sidtupper/WX-system/(list of files, drawings)

Other design files:
hardware/gateway/gateway.dsn
hardware/midpoint/midpoint.dsn
hardware/station/station.dsn
