sidtupper/WX-system/docs/Station_Pi_Hardware_Software_Maintenance_Manual.docx

# Station Pi Hardware & Software Maintenance Manual

Raspberry Pi 4B remote weather-station controller
Configuration captured 27 August 2026

Purpose. A practical maintenance record of the Station Pi hardware interfaces, software services, boot configuration, networking, data flow, backup strategy, and diagnostic procedures. It is intended to make future maintenance possible without relying on memory.

Important: this manual distinguishes verified configuration from items that still need review. Do not change working UART or power-monitor settings solely to make comments or old documentation look consistent.

# 1. System overview

The Station Pi is the shore-side Raspberry Pi 4B controller for the weather station. It acquires local weather and enclosure measurements, displays observations on the enclosure TFT, logs observations locally, and normally forwards a formatted observation packet to the station ESP32/LoRa subsystem. Protective functions such as enclosure heating, door-controlled display backlight, safe shutdown, and Wi-Fi fallback run as independent services.

Function | Implementation
Main controller | Raspberry Pi 4B, 64-bit Linux
System disk | T-FORCE 256 GB USB SSD; root on /dev/sda2, boot on /dev/sda1
Emergency boot disk | 32 GB microSD, tested bootable independently of SSD
Main program | /home/pi/wx/scripts/station.py
Observation interval | 30 s (current station.py default)
Local observations | /home/pi/wx/data/weather.csv and /home/pi/wx/data/latest.txt
Maintenance access | SSH/SFTP; fallback AP WX-STATION at 10.42.0.1

# 2. Hardware interface map

BCM GPIO | Physical role / interface | Direction / verified state
4 | UART3 TX to station ESP32 | TXD3; verified by pinctrl
5 | UART3 RX from station ESP32 | RXD3; verified by pinctrl
8 | TFT SPI chip select | Output
10 | TFT SPI MOSI | SPI0_MOSI
11 | TFT SPI clock | SPI0_SCLK
12 | RS-485 UART5 TX | TXD5; verified by pinctrl
13 | RS-485 UART5 RX | RXD5; verified by pinctrl
16 | Enclosure heater MOSFET gate | Output; active high
17 | TFT backlight | Output; high = backlight on
20 | Normally-closed door switch | Input pull-up; LOW when door open
21 | Safe shutdown toggle | Input pull-up; grounded when closed
24 | TFT reset | Output
25 | TFT data/command | Output
27 | 1-Wire DS18B20 bus | Input / w1-gpio

# 3. Sensors and buses

Device | Interface | Address / port | Notes
Wind Mini-C5A | RS-485 Modbus RTU | Slave 1, /dev/ttyAMA5, 9600 8N1 | Speed, direction, air temperature, RH, pressure
Rain SN-3001-GYL-N01 | RS-485 Modbus RTU | Slave 2, /dev/ttyAMA5, 9600 8N1 | Rainfall
BME280 | I2C bus 1 | 0x76 | Enclosure T/RH for heater; also detected by POST
INA226 | I2C bus 1 | 0x40 | Station supply voltage/current
DS18B20 x2 | 1-Wire | GPIO27 | Sea and cabinet temperature; POST expects at least two
GPS receiver | Serial | /dev/serial0, 9600 | POST accepts usable RMC/GGA NMEA
TFT | SPI0 | GPIO8/10/11 plus GPIO24/25 | stationio.ili9488 driver
Station ESP32 | UART3 | /dev/ttyAMA3, GPIO4/5, 9600 | Observation packet output; local logging should continue if unavailable

# 4. Power and enclosure protection

## 4.1 Enclosure heater

A nominal 10 W / 12 V heater is bonded to the aluminium mounting plate and switched on the low side by an IRLZ44N MOSFET controlled from GPIO16. A measured 11.8 V across the heater while on confirmed approximately rated operation.

Condition | Action
RH >= 75% | Turn heater ON
Temperature - dew point <= 2 C | Turn heater ON
RH <= 65% AND dew-point margin >= 5 C | Turn heater OFF
Reading interval | 30 s

The heater controller is intentionally independent of station.py. Thus condensation protection remains active if the main acquisition program is stopped, upgraded, or crashes.

## 4.2 Safe shutdown switch

Physical header pin 40 (BCM GPIO21) is connected to ground by the shutdown toggle. The service does not arm until it has observed the switch open/high, preventing a switch left closed from immediately shutting the Pi down after reboot. After arming, holding GPIO21 low for one second invokes systemctl poweroff.

## 4.3 Door-controlled TFT backlight

The normally-closed door switch connects GPIO20 to ground when the enclosure door is open. GPIO20 therefore reads LOW when open and HIGH via its internal pull-up when closed. The door-backlight service drives GPIO17 HIGH when the door is open and LOW when closed.

# 5. Boot configuration

Current SSD boot identifiers:

/boot/firmware PARTUUID=73a882b0-01

/ PARTUUID=73a882b0-02

Current cmdline.txt:

console=tty1 root=PARTUUID=73a882b0-02 rootfstype=ext4 fsck.repair=yes rootwait cfg80211.ieee80211_regdom=CA

Relevant config.txt settings:

dtparam=i2c_arm=on

dtparam=spi=on

arm_64bit=1

enable_uart=1

dtoverlay=w1-gpio,gpiopin=27

dtoverlay=uart5,txd4_pin=12,rxd4_pin=13

dtoverlay=uart3,txd3_pin=4

Verified runtime pinctrl mapping is authoritative for maintenance: GPIO12=TXD5, GPIO13=RXD5, GPIO4=TXD3 and GPIO5=RXD3. The uart5 overlay line contains parameter names 'txd4_pin'/'rxd4_pin', and the ESP32 comment in config.txt is stale. Because the runtime mapping has been verified and is working, review these lines deliberately rather than changing them casually.

# 6. Software architecture and systemd services

Service | Program | Behaviour
station.service | /home/pi/wx/scripts/station.py | User pi; working dir /home/pi/wx; 15 s startup delay; Restart=always; RestartSec=10; Nice=5
heater.service | /home/pi/wx/scripts/heater_bme280.py | Independent condensation controller; Restart=always
gpio-shutdown.service | /usr/local/sbin/gpio-shutdown.py | Safe GPIO21 shutdown; Restart=on-failure
door-backlight.service | /usr/local/sbin/door-backlight.py | Door switch GPIO20 -> backlight GPIO17; Restart=on-failure
wx-wifi-fallback.service | /usr/local/sbin/wx-wifi-fallback.sh | One-shot after NetworkManager; RemainAfterExit=yes; 90 s timeout

Useful service commands:

systemctl status station.service heater.service gpio-shutdown.service door-backlight.service wx-wifi-fallback.service

journalctl -u station.service -n 50 --no-pager

journalctl -u heater.service -n 50 --no-pager

journalctl -b

# 7. Main station.py data flow

station.py opens the RS-485 weather bus on /dev/ttyAMA5 and the station ESP32 link on /dev/ttyAMA3. Each successful cycle reads the weather instruments and local sensors, builds an observation record, updates the TFT, writes the observation locally, and attempts transmission to the ESP32.

Observation payload fields, in order:

@epoch,wind_speed,wind_dir,wind_gust,temperature,humidity,barometric_pressure,rain_hour,sea_temp,cabinet_temp,station_battery*CRC

The locally logging version creates /home/pi/wx/data at startup. weather.csv is the accumulating history; latest.txt is replaced with the newest successful observation. Local saving occurs before ESP32 transmission so an unavailable midpoint/LoRa path does not by itself prevent on-site data collection.

# 8. Network design

Saved NetworkManager Wi-Fi profiles are TELUS4628 and stonehouse. The fallback service first stops hostapd/dnsmasq, returns wlan0 to NetworkManager, enables Wi-Fi, and waits up to 60 seconds for a saved client connection with an IPv4 address. If none becomes available it disconnects wlan0 from NetworkManager, marks it unmanaged, assigns 10.42.0.1/24, then starts hostapd and dnsmasq. The expected access-point SSID is WX-STATION.

Situation | Expected access
Home Ethernet (captured state) | 192.168.10.109/24 on eth0
Saved Wi-Fi available | NetworkManager client connection
No saved Wi-Fi available | WX-STATION AP, Pi = 10.42.0.1/24
File maintenance | SFTP over SSH, normally port 22

A captured home-state snapshot showed Ethernet connected at 192.168.10.109 while wlan0 was unmanaged with 10.42.0.1/24, consistent with the fallback AP having been established.

# 9. Power-on self test (run_post.py)

The POST is a manual diagnostic program. It tests wind, rain, BME280, INA226, at least two DS18B20 sensors, GPS/NMEA, filesystem writability/free space, system clock, heater/shutdown/door services, Wi-Fi fallback result, current network/AP state, and TFT initialization. It displays POST PASS only if every recorded test passes; otherwise POST FAIL.

POST default | Value
RS-485 | /dev/ttyAMA5, 9600
Wind slave | 1
Rain slave | 2
BME280 | 0x76
INA226 | 0x40
Expected DS18B20 | 2
GPS | /dev/serial0, 9600
Hotspot | WX-STATION / 10.42.0.1
Minimum free disk | 5 GB

Known discrepancy requiring review: run_post.py currently defaults INA226 shunt resistance to 0.102 ohm, while the current station.py uses 0.0275 ohm with a comment that it was calibrated with a DMM. Do not use POST current readings as a calibration reference until the physical shunt value is confirmed and both programs are made consistent.

# 10. Storage and backup

The primary system is on a 256 GB T-FORCE USB SSD. At the captured state the root filesystem used about 4.4 GB. A 32 GB microSD was built as a file-level clone using rsync, given independent partition identifiers, and successfully test-booted with the SSD disconnected.

Emergency SD partition | Identifier
bootfs | PARTUUID=cabd7190-01
station-backup root | PARTUUID=cabd7190-02

The successful test showed /dev/mmcblk0p1 mounted at /boot/firmware and /dev/mmcblk0p2 mounted at /. Label the card clearly and keep it as an emergency boot disk. A backup is much more valuable after an actual independent boot test, which this card has passed.

## 10.1 Refreshing the emergency SD clone

When refreshing the card, do not raw-dd the 238 GB SSD to the 32 GB card. Recreate suitable FAT/ext4 partitions, rsync the live filesystem with virtual filesystems excluded, then change the clone's cmdline.txt and /etc/fstab to the clone's own PARTUUID values. Always verify device names before formatting.

# 11. Maintenance quick checks

# Root/boot device

findmnt /

findmnt /boot/firmware

lsblk -o NAME,SIZE,FSTYPE,LABEL,MOUNTPOINTS,MODEL

# I2C devices

i2cdetect -y 1

# Expected: 0x40 INA226, 0x76 BME280

# UART devices

ls -l /dev/ttyAMA*

# Expected: ttyAMA3 and ttyAMA5

# GPIO function

for p in 4 5 8 10 11 12 13 16 17 20 21 24 25 27; do pinctrl get $p; done

# Main services

systemctl is-active station.service heater.service gpio-shutdown.service door-backlight.service

systemctl status wx-wifi-fallback.service --no-pager

# Recent station log

journalctl -u station.service -n 100 --no-pager

# Local observations

ls -lh /home/pi/wx/data

tail /home/pi/wx/data/weather.csv

cat /home/pi/wx/data/latest.txt

# 12. Troubleshooting guide

Symptom | Checks
No observations logged | Check station.service journal; confirm /dev/ttyAMA5; verify wind/rain RS-485 responses. A failed sensor cycle can prevent a complete observation.
Wind/rain missing | Check GPIO12/13 pinctrl = TXD5/RXD5, /dev/ttyAMA5 exists, 9600 8N1, slave IDs 1 and 2.
No BME280/heater | i2cdetect -y 1 should show 0x76; check heater.service journal and GPIO16.
Bad battery current | Resolve INA226 shunt-value discrepancy before interpreting current.
TFT dark | Open door; GPIO20 should go LOW and GPIO17 HIGH. Check door-backlight.service.
Pi will not shut down from switch | Ensure switch was first opened after boot so service arms; then GPIO21 LOW for >=1 s.
Cannot reach station at site | Look for WX-STATION; connect and SSH/SFTP to 10.42.0.1. Check hostapd/dnsmasq and wx-wifi-fallback logs.
SSD boot failure | Power off, disconnect SSD, insert tested emergency microSD, boot and verify root is /dev/mmcblk0p2.

# 13. Known issues / items to verify

- INA226 shunt resistance: station.py = 0.0275 ohm; run_post.py = 0.102 ohm. Confirm physical/calibrated value and standardize.
- config.txt uart5 line uses txd4_pin/rxd4_pin parameter names although runtime GPIO12/13 are verified as TXD5/RXD5.
- config.txt comment for the ESP32 link says GPIO19/GPIO26, but verified Station Pi UART3 pins are GPIO4/GPIO5.
- POST is currently a manual diagnostic; no post.service has been documented as installed/enabled.
- When both DS18B20 sensors are installed, record their full 28-... ROM IDs and which one is sea versus cabinet. This will remove ambiguity if enumeration order changes.

# 14. Configuration snapshot

Verified pinctrl snapshot (27 Aug 2026):

GPIO4 = TXD3

GPIO5 = RXD3

GPIO8 = output

GPIO10 = SPI0_MOSI

GPIO11 = SPI0_SCLK

GPIO12 = TXD5

GPIO13 = RXD5

GPIO16 = output

GPIO17 = output

GPIO20 = input pull-up

GPIO21 = input pull-up

GPIO24 = output

GPIO25 = output

GPIO27 = input

Detected I2C devices: 0x40 and 0x76. Character devices present: /dev/ttyAMA3 and /dev/ttyAMA5.

# 15. Maintenance notes

When changing hardware or software, update this document at the same time. Particularly important items to record are GPIO changes, UART overlays, Modbus slave addresses, DS18B20 ROM IDs, service filenames, thresholds, filesystem PARTUUIDs, hotspot configuration, and any calibration constants.

Before a remote deployment, prefer a tested configuration over a cosmetically cleaner one. Make one change at a time, verify it locally, and retain the known-good bootable SD card.

Maintenance reference - configuration captured 2026-08-27

Station Pi - Hardware & Software Maintenance Manual
